NVHMH/Self_Balancing_Robot_PID/HW/mechanical/driver_board.jpg

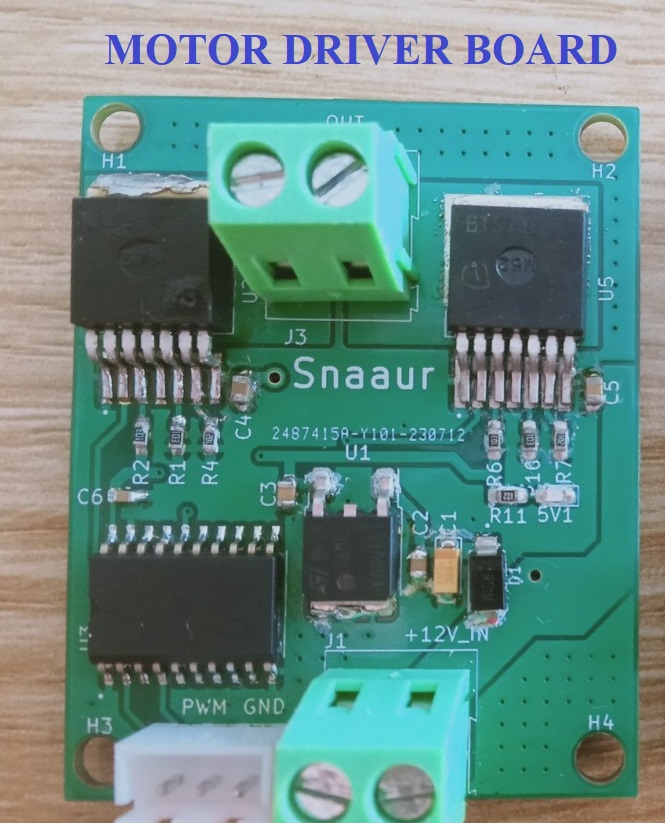
HW/mechanical/driver_board.jpg
