NVHMH/Self_Balancing_Robot_PID/HW/mechanical/main_board.jpg

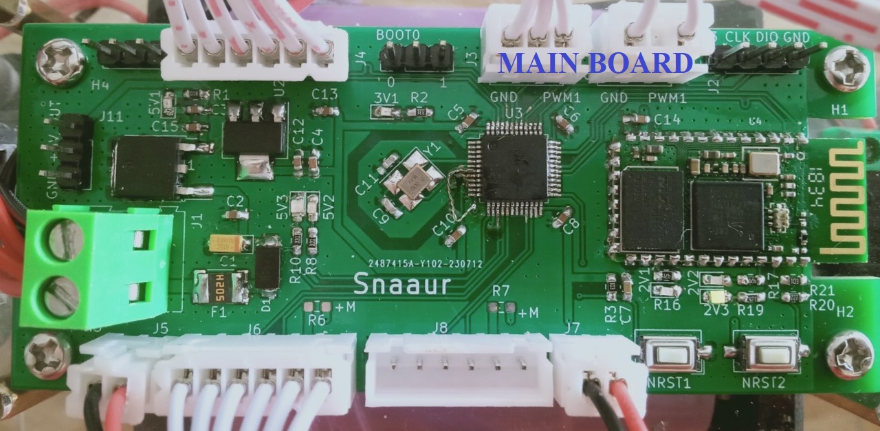
HW/mechanical/main_board.jpg
