NVHMH/Self_Balancing_Robot_PID/HW/mechanical/Front_robot.png

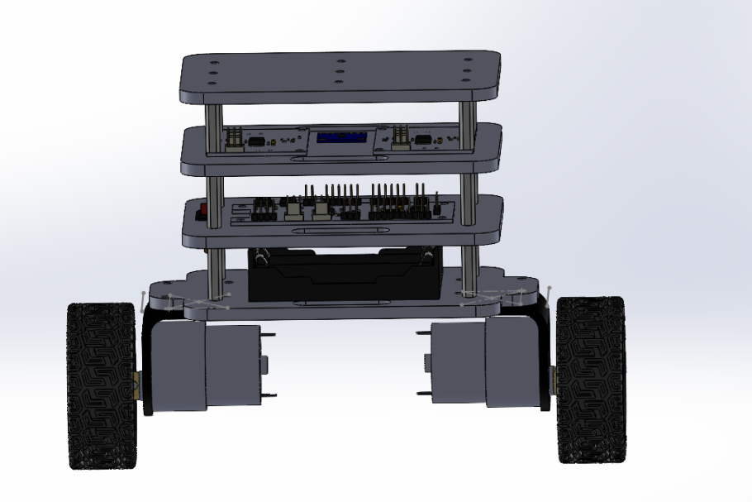
HW/mechanical/Front_robot.png
