NVHMH/Self_Balancing_Robot_PID/HW/mechanical/Right_robot.png

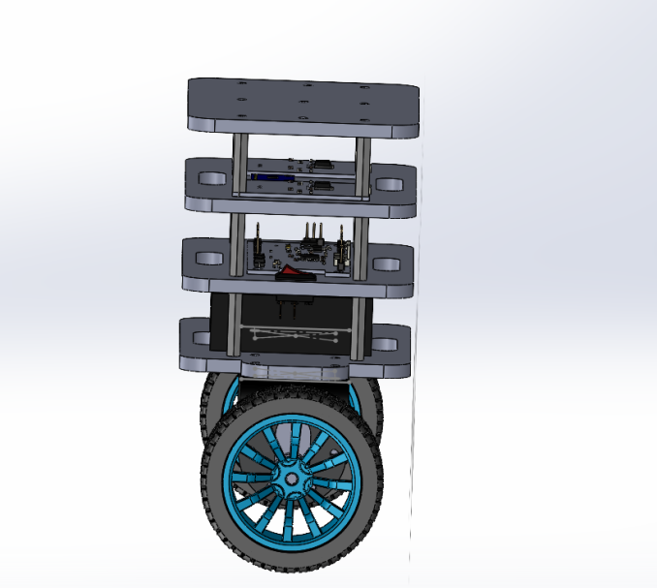
HW/mechanical/Right_robot.png
