NVHMH/Self_Balancing_Robot_PID/HW/mechanical/robot.jpg

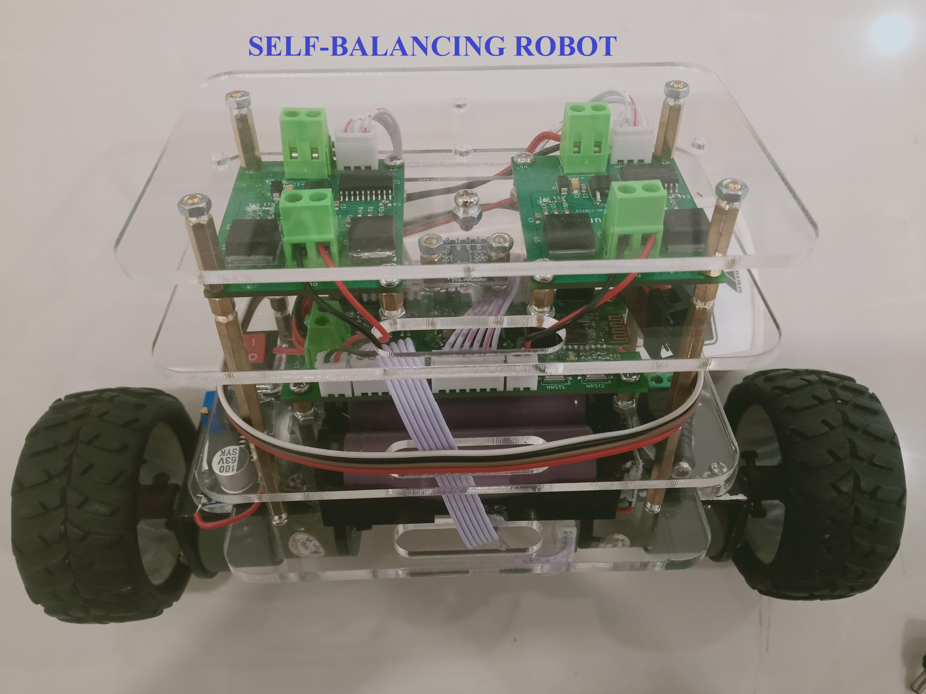
HW/mechanical/robot.jpg
