NVHMH/Self_Balancing_Robot_PID/HW/mechanical/Top_robot.png

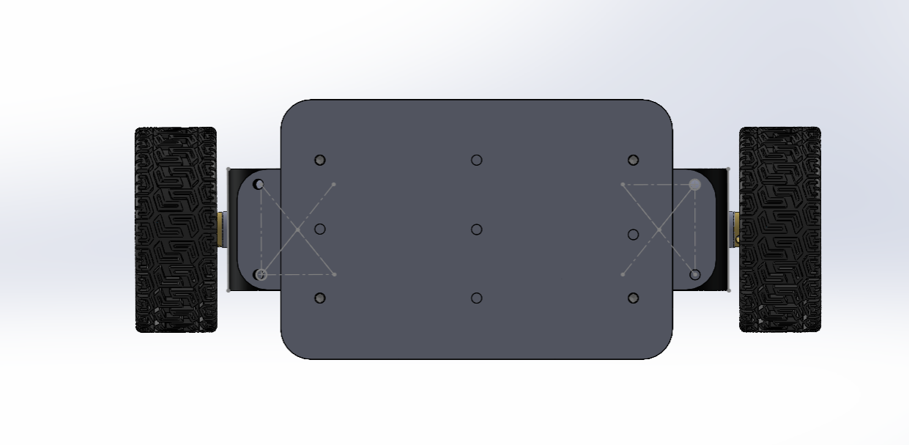
HW/mechanical/Top_robot.png
