NVHMH/Self_Balancing_Robot_PID/HW/main_board/snaaur_v1.xlsx

# | Reference | Qty | Value | Footprint | DNP
1 | 2V1 | 1 | RED | LED_SMD:LED_0603_1608Metric_Pad1.05x0.95mm_HandSolder | LED Xanh Lá 0603 Dán SMD Trong Suốt Size 1.6x0.8mm, điện áp 1.8-2.6VDC (thegioiic.com) (https://www.thegioiic.com/led-xanh-la-0603-dan-smd-trong-suot)
2 | 2V2 | 1 | YELLOW | LED_SMD:LED_0603_1608Metric_Pad1.05x0.95mm_HandSolder | LED Xanh Lá 0603 Dán SMD Trong Suốt Size 1.6x0.8mm, điện áp 1.8-2.6VDC (thegioiic.com) (https://www.thegioiic.com/led-xanh-la-0603-dan-smd-trong-suot)
3 | 2V3 | 1 | GREEN | LED_SMD:LED_0603_1608Metric_Pad1.05x0.95mm_HandSolder | LED Xanh Lá 0603 Dán SMD Trong Suốt Size 1.6x0.8mm, điện áp 1.8-2.6VDC (thegioiic.com) (https://www.thegioiic.com/led-xanh-la-0603-dan-smd-trong-suot)
4 | 3V1, 5V1, 5V2, 5V3 | 4 | LED | LED_SMD:LED_0603_1608Metric_Pad1.05x0.95mm_HandSolder | LED Đỏ 0603 Dán SMD Trong Suốt Size 1.6x0.8mm, điện áp 1.8-2.6VDC (thegioiic.com) (https://www.thegioiic.com/led-do-0603-dan-smd-trong-suot)
5 | C1 | 1 | 1u, 16V | Capacitor_Tantalum_SMD:CP_EIA-3216-18_Kemet-A_Pad1.58x1.35mm_HandSolder | Tụ Tantalum 1uF 16V 1206 TAJA105K016RNJ, Code 105 10%, 1206 (3216 Metric) (thegioiic.com) (https://www.thegioiic.com/tu-tantalum-1uf-16v-1206-taja105k016rnj)
6 | C2, C15 | 2 | 100nF,50V | Capacitor_SMD:C_0603_1608Metric_Pad1.05x0.95mm_HandSolder | Tụ Gốm 0603 100nF (0.1uF) 50V 10%, 0603 (1608 Metric) (thegioiic.com) (https://www.thegioiic.com/tu-gom-0603-100nf-0-1uf-50v)
7 | C3, C4, C5, C6, C7, C8, C10, C13, C14 | 9 | 100n | Capacitor_SMD:C_0603_1608Metric_Pad1.08x0.95mm_HandSolder | Tụ Gốm 0603 100nF (0.1uF) 50V 10%, 0603 (1608 Metric) (thegioiic.com) (https://www.thegioiic.com/tu-gom-0603-100nf-0-1uf-50v)
8 | C9, C11 | 2 | 22p | Capacitor_SMD:C_0603_1608Metric_Pad1.08x0.95mm_HandSolder | Tụ Gốm 0603 22pF 50V 10%, 0603 (1608 Metric) (thegioiic.com) (https://www.thegioiic.com/tu-gom-0603-22pf-50v)
9 | C12 | 1 | 4.7u thay bằng 1uF/16V | Capacitor_SMD:C_0603_1608Metric_Pad1.08x0.95mm_HandSolder | Tụ Gốm 0603 4.7uF 25V 10%, 0603 (1608 Metric) (thegioiic.com) (https://www.thegioiic.com/tu-gom-0603-4-7uf-25v)
10 | D1 | 1 | RS1M | RS1M:DIOM4330X250N | RS1M SMA Diode Chỉnh Lưu 1A 1KV, 1A, 1KV, SMA (thegioiic.com) (https://www.thegioiic.com/rs1m-sma-diode-chinh-luu-1a-1kv)
11 | F1 | 1 | Fuse | Fuse:Fuse_1812_4532Metric_Pad1.30x3.40mm_HandSolder | https://www.thegioiic.com/mf-msmf050-2-cau-chi-tu-phuc-hoi-1812-15v-0-5a
12 | H1, H2, H3, H4 | 4 | MountingHole | MountingHole:MountingHole_3.5mm | x
13 | J1 | 1 | POWER | TerminalBlock:TerminalBlock_Altech_AK300-2_P5.00mm | hàng rào đực
14 | J2 | 1 | Debug | Connector_PinHeader_2.54mm:PinHeader_1x04_P2.54mm_Vertical
15 | J3 | 1 | boot | Connector_PinHeader_2.54mm:PinHeader_1x03_P2.54mm_Vertical | x
16 | J4 | 1 | MPU6050 | Connector_PinHeader_2.54mm:PinHeader_1x10_P2.54mm_Vertical
17 | J5, J7 | 2 | Conn_01x02_Pin | Connector_PinHeader_2.54mm:PinHeader_1x02_P2.54mm_Vertical
18 | J6 | 1 | Motor1 | Connector_PinHeader_2.54mm:PinHeader_1x06_P2.54mm_Vertical | Dây Tín Hiệu Có Đầu Nối (thegioiic.com) (https://www.thegioiic.com/product/day-tin-hieu-co-dau-noi?prid=9485,9526)
19 | J8 | 1 | Motor2 | Connector_PinHeader_2.54mm:PinHeader_1x06_P2.54mm_Vertical | Đầu XH 2.54mm 6 Chân Thẳng Xuyên Lỗ, 250V 3A (thegioiic.com) (https://www.thegioiic.com/dau-xh-2-54mm-6-chan-thang-xuyen-lo)
20 | J9 | 1 | PWM1 | Connector_PinHeader_2.54mm:PinHeader_1x03_P2.54mm_Vertical | https://www.thegioiic.com/day-bus-cai-cai-3-tiep-diem-2-54mm-dai-20cm
21 | J10 | 1 | PWM2 | Connector_PinHeader_2.54mm:PinHeader_1x03_P2.54mm_Vertical | Đầu XH 2.54mm 3 Chân Thẳng Xuyên Lỗ, 250V 3A (thegioiic.com) (https://www.thegioiic.com/dau-xh-2-54mm-3-chan-thang-xuyen-lo)
22 | J11 | 1 | 5V_Output | Connector_PinHeader_2.54mm:PinHeader_1x02_P2.54mm_Vertical
23 | NRST1, NRST2 | 2 | SW_Push | Button_Switch_SMD:SW_DIP_SPSTx01_Slide_6.7x4.1mm_W6.73mm_P2.54mm_LowProfile_JPin | Nút Nhấn 3.5x6mm Cao 2.5mm 2 Chân SMD Đầu Trắng 12VDC 0.1A (thegioiic.com) (https://www.thegioiic.com/nut-nhan-3-5x6mm-cao-2-5mm-2-chan-smd-dau-trang)
24 | R1 | 1 | 1k | Resistor_SMD:R_0603_1608Metric_Pad0.98x0.95mm_HandSolder | Điện Trở 1 KOhm 0603 1%, Code 102, 1/10W (thegioiic.com) (https://www.thegioiic.com/dien-tro-1-kohm-0603-1)
25 | R2, R8, R10 | 3 | 330 | Resistor_SMD:R_0603_1608Metric_Pad0.98x0.95mm_HandSolder | Điện Trở 330 Ohm 0603 1%, Code 331, 1/10W (thegioiic.com) (https://www.thegioiic.com/dien-tro-330-ohm-0603-1-)
26 | R3, R21 | 2 | 10k | Resistor_SMD:R_0603_1608Metric_Pad0.98x0.95mm_HandSolder | Điện Trở 330 Ohm 0603 1%, Code 331, 1/10W (thegioiic.com) (https://www.thegioiic.com/dien-tro-330-ohm-0603-1-)
27 | R6, R7 | 2 | 0 | Resistor_SMD:R_0603_1608Metric_Pad0.98x0.95mm_HandSolder | Điện Trở 0 Ohm 0603 1%, Code 0R0, 1/10W (thegioiic.com) (https://www.thegioiic.com/dien-tro-0-ohm-0603-1)
28 | R16, R17, R19 | 3 | 470 | Resistor_SMD:R_0603_1608Metric_Pad0.98x0.95mm_HandSolder | Điện Trở 470 Ohm 0603 1%, Code 471, 1/10W (thegioiic.com) (https://www.thegioiic.com/dien-tro-470-ohm-0603-1-)
29 | R20 | 1 | 2.2k | Resistor_SMD:R_0603_1608Metric_Pad0.98x0.95mm_HandSolder | Điện Trở 2.2 KOhm 0603 1%, Code 222, 1/10W (thegioiic.com) (https://www.thegioiic.com/dien-tro-2-2-kohm-0603-1)
30 | U1 | 1 | L7805 | Package_TO_SOT_SMD:TO-252-2 | L78M05CDT IC Ổn Áp 5V 500mA Điện áp vào max: 35VDC, điện áp ra: 5VDC, TO-252 (thegioiic.com) (https://www.thegioiic.com/l78m05cdt-ic-on-ap-5v-500ma)
31 | U2 | 1 | AMS1117-3.3 | Package_TO_SOT_SMD:SOT-223-3_TabPin2 | AMS1117-3.3V IC Ổn Áp 3.3V 1A SOT-223 Điện áp vào max: 15VDC, điện áp ra: 3.3VDC (thegioiic.com) (https://www.thegioiic.com/ams1117-3-3v-ic-on-ap-3-3v-1a-sot-223)
32 | U3 | 1 | STM32F103C8Tx | Package_QFP:LQFP-48_7x7mm_P0.5mm | STM32F103C8T6 (icdayroi.com) (https://icdayroi.com/stm32f103c8t6)
33 | U4 | 1 | HC-05 | HC-05:XCVR_HC-05 | https://www.thegioiic.com/hc-05-thu-phat-bluetooth-chua-ra-chan-master-slave
34 | Y1 | 1 | Crystal | Crystal:Crystal_SMD_3225-4Pin_3.2x2.5mm_HandSoldering | Thạch Anh 8MHz 3225 4 Chân SMD Size: 3.2x2.5mm, ±15ppm 8pF (thegioiic.com) (https://www.thegioiic.com/thach-anh-8mhz-3225-4-chan-smd)
