NVHMH/Self_Balancing_Robot_PID/HW/driver_motor/driver_motor.step

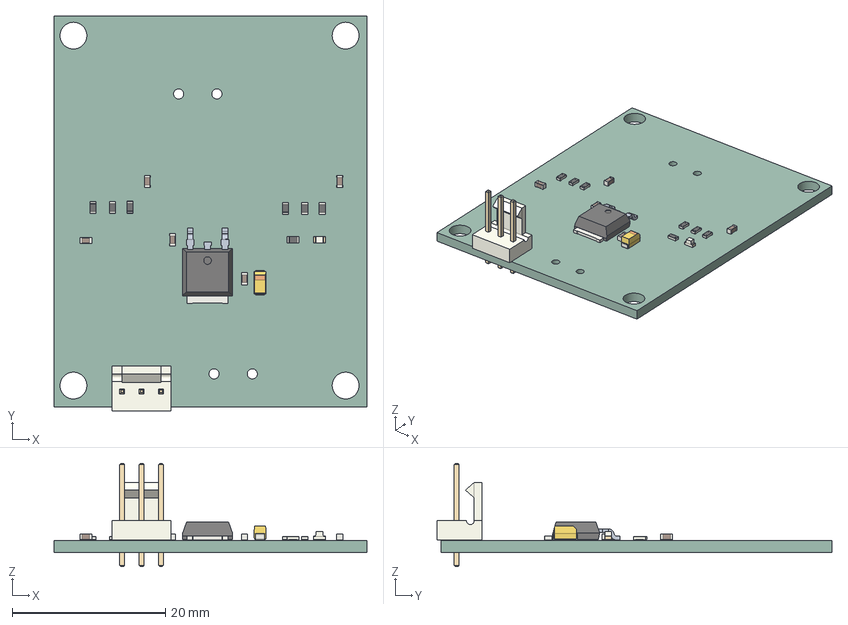
[picture p7: CAD file, 2023-07-31]
HW/driver_motor/driver_motor.step
40.9 x 51.6 x 13.5 mm
driver_motor PCB
