NVHMH/Self_Balancing_Robot_PID/(list of files, cad)

Other CAD files:
HW/mechanical/Simulation_solidworks/Self_balancing_robot_simulation.STEP[50].sldprt
HW/mechanical/Simulation_solidworks/Self_balancing_robot_simulation.STEP[133].sldprt
HW/mechanical/Simulation_solidworks/Self_balancing_robot_simulation.STEP[24].sldprt
HW/mechanical/Simulation_solidworks/Self_balancing_robot_simulation.STEP[82].sldprt
HW/mechanical/Simulation_solidworks/Self_balancing_robot_simulation.STEP[71].sldprt
HW/mechanical/Simulation_solidworks/Self_balancing_robot_simulation.STEP[119].sldprt
HW/mechanical/Simulation_solidworks/Self_balancing_robot_simulation.STEP[104].sldprt
HW/mechanical/Simulation_solidworks/Self_balancing_robot_simulation.STEP[99].sldprt
HW/mechanical/Simulation_solidworks/Self_balancing_robot_simulation.STEP[23].sldprt
HW/mechanical/Simulation_solidworks/Self_balancing_robot_simulation.STEP[98].sldprt
HW/mechanical/Simulation_solidworks/Self_balancing_robot_simulation.STEP[8].sldprt
HW/mechanical/Simulation_solidworks/Self_balancing_robot_simulation.STEP[130].sldprt
HW/mechanical/Simulation_solidworks/Self_balancing_robot_simulation.STEP[70].sldprt
HW/mechanical/Simulation_solidworks/Self_balancing_robot_simulation.STEP[37].sldprt
HW/mechanical/Simulation_solidworks/Self_balancing_robot_simulation.STEP[17].sldprt
HW/mechanical/Simulation_solidworks/Self_balancing_robot_simulation.STEP[55].sldprt
HW/mechanical/Simulation_solidworks/Self_balancing_robot_simulation.STEP[92].sldprt
HW/mechanical/Simulation_solidworks/Self_balancing_robot_simulation.STEP[75].sldprt
HW/mechanical/Simulation_solidworks/Self_balancing_robot_simulation.STEP[60].sldprt
HW/mechanical/Simulation_solidworks/Self_balancing_robot_simulation.STEP[41].sldprt
HW/mechanical/Simulation_solidworks/Self_balancing_robot_simulation.STEP[73].sldprt
HW/mechanical/Simulation_solidworks/Self_balancing_robot_simulation.STEP[90].sldprt
HW/mechanical/Simulation_solidworks/Self_balancing_robot_simulation.STEP[93].sldprt
HW/mechanical/Simulation_solidworks/Self_balancing_robot_simulation.STEP[116].sldprt
HW/mechanical/Simulation_solidworks/Self_balancing_robot_simulation.STEP[57].sldprt
HW/mechanical/Simulation_solidworks/Self_balancing_robot_simulation.STEP[122].sldprt
HW/mechanical/Simulation_solidworks/Self_balancing_robot_simulation.STEP[111].sldprt
HW/mechanical/Simulation_solidworks/Self_balancing_robot_simulation.STEP[32].sldprt
HW/mechanical/Simulation_solidworks/Self_balancing_robot_simulation.STEP[62].sldprt
HW/mechanical/Simulation_solidworks/Self_balancing_robot_simulation.STEP[20].sldprt
HW/mechanical/Simulation_solidworks/Self_balancing_robot_simulation.STEP[86].sldprt
HW/mechanical/Simulation_solidworks/Self_balancing_robot_simulation.STEP[5].sldprt
HW/mechanical/Simulation_solidworks/Self_balancing_robot_simulation.STEP[34].sldprt
HW/mechanical/Simulation_solidworks/Self_balancing_robot_simulation.STEP[88].sldprt
HW/mechanical/Simulation_solidworks/Self_balancing_robot_simulation.STEP[10].sldprt
HW/mechanical/Simulation_solidworks/Self_balancing_robot_simulation.STEP[21].sldprt
HW/mechanical/Simulation_solidworks/Self_balancing_robot_simulation.STEP[14].sldprt
HW/mechanical/Simulation_solidworks/Self_balancing_robot_simulation.STEP[101].sldprt
HW/mechanical/Simulation_solidworks/Self_balancing_robot_simulation.STEP[113].sldprt
HW/mechanical/Simulation_solidworks/Self_balancing_robot_simulation.STEP[33].sldprt
HW/mechanical/Simulation_solidworks/Self_balancing_robot_simulation.STEP[18].sldprt
HW/mechanical/Simulation_solidworks/Self_balancing_robot_simulation.STEP[117].sldprt
HW/mechanical/Simulation_solidworks/Self_balancing_robot_simulation.STEP[43].sldprt
HW/mechanical/Simulation_solidworks/Self_balancing_robot_simulation.STEP[31].sldprt
HW/mechanical/Simulation_solidworks/Self_balancing_robot_simulation.STEP[96].sldprt
HW/mechanical/Simulation_solidworks/Self_balancing_robot_simulation.STEP[49].sldprt
HW/mechanical/Simulation_solidworks/Self_balancing_robot_simulation.STEP[87].sldprt
HW/mechanical/Simulation_solidworks/Self_balancing_robot_simulation.STEP[85].sldprt
HW/mechanical/Simulation_solidworks/Self_balancing_robot_simulation.STEP[52].sldprt
HW/mechanical/Simulation_solidworks/Self_balancing_robot_simulation.STEP[106].sldprt
HW/mechanical/Simulation_solidworks/Self_balancing_robot_simulation.STEP[27].sldprt
HW/mechanical/Simulation_solidworks/Self_balancing_robot_simulation.STEP[77].sldprt
HW/mechanical/Simulation_solidworks/Self_balancing_robot_simulation.STEP[59].sldprt
HW/mechanical/Simulation_solidworks/Self_balancing_robot_simulation.STEP[16].sldprt
HW/mechanical/Simulation_solidworks/Self_balancing_robot_simulation.STEP[132].sldprt
HW/mechanical/Simulation_solidworks/Self_balancing_robot_simulation.STEP[39].sldprt
HW/mechanical/Simulation_solidworks/Self_balancing_robot_simulation.STEP[128].sldprt
HW/mechanical/Simulation_solidworks/Self_balancing_robot_simulation.STEP[2].sldprt
HW/mechanical/Simulation_solidworks/Self_balancing_robot_simulation.STEP[25].sldprt
HW/mechanical/Simulation_solidworks/Self_balancing_robot_simulation.STEP[127].sldprt
HW/mechanical/Simulation_solidworks/Self_balancing_robot_simulation.STEP[107].sldprt
HW/mechanical/Simulation_solidworks/Self_balancing_robot_simulation.STEP[67].sldprt
HW/mechanical/Simulation_solidworks/Self_balancing_robot_simulation.STEP[80].sldprt
HW/mechanical/Simulation_solidworks/Self_balancing_robot_simulation.STEP[29].sldprt
HW/mechanical/Simulation_solidworks/Self_balancing_robot_simulation.STEP[36].sldprt
HW/mechanical/Simulation_solidworks/Self_balancing_robot_simulation.STEP[131].sldprt
HW/mechanical/Simulation_solidworks/Self_balancing_robot_simulation.STEP[100].sldprt
HW/mechanical/Simulation_solidworks/Self_balancing_robot_simulation.STEP[19].sldprt
HW/mechanical/Simulation_solidworks/Self_balancing_robot_simulation.STEP[76].sldprt
HW/mechanical/Simulation_solidworks/Self_balancing_robot_simulation.STEP[44].sldprt
HW/mechanical/Simulation_solidworks/Self_balancing_robot_simulation.STEP[95].sldprt
HW/mechanical/Simulation_solidworks/Self_balancing_robot_simulation.STEP[78].sldprt
HW/mechanical/Simulation_solidworks/Self_balancing_robot_simulation.STEP[125].sldprt
HW/mechanical/Simulation_solidworks/Self_balancing_robot_simulation.STEP[7].sldprt
HW/mechanical/Simulation_solidworks/Self_balancing_robot_simulation.STEP[45].sldprt
HW/mechanical/Simulation_solidworks/Self_balancing_robot_simulation.STEP[42].sldprt
HW/mechanical/Simulation_solidworks/Self_balancing_robot_simulation.STEP[89].sldprt
HW/mechanical/Simulation_solidworks/Self_balancing_robot_simulation.STEP[129].sldprt
HW/mechanical/Simulation_solidworks/Self_balancing_robot_simulation.STEP[114].sldprt
HW/mechanical/Simulation_solidworks/Self_balancing_robot_simulation.STEP[48].sldprt
HW/mechanical/Simulation_solidworks/Self_balancing_robot_simulation.STEP[97].sldprt
HW/mechanical/Simulation_solidworks/Self_balancing_robot_simulation.STEP[110].sldprt
HW/mechanical/Simulation_solidworks/Self_balancing_robot_simulation.STEP[124].sldprt
HW/mechanical/Simulation_solidworks/Self_balancing_robot_simulation.STEP[65].sldprt
HW/mechanical/Simulation_solidworks/Self_balancing_robot_simulation.STEP[15].sldprt
HW/mechanical/Simulation_solidworks/Self_balancing_robot_simulation.STEP[51].sldprt
HW/mechanical/Simulation_solidworks/Self_balancing_robot_simulation.STEP[22].sldprt
HW/mechanical/Simulation_solidworks/Self_balancing_robot_simulation.STEP[126].sldprt
HW/mechanical/Simulation_solidworks/Self_balancing_robot_simulation.STEP[35].sldprt
HW/mechanical/Simulation_solidworks/Self_balancing_robot_simulation.STEP[109].sldprt
HW/mechanical/Simulation_solidworks/Self_balancing_robot_simulation.STEP[69].sldprt
HW/mechanical/Simulation_solidworks/Self_balancing_robot_simulation.STEP[123].sldprt
HW/mechanical/Simulation_solidworks/Self_balancing_robot_simulation.STEP[64].sldprt
HW/mechanical/Simulation_solidworks/Self_balancing_robot_simulation.STEP[112].sldprt
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
