NVHMH/Self_Balancing_Robot_PID/Document_Report/tune_pid.xlsx

kp | ki | kd | setpoint | MAX_CNT | MIN_CNT | t_angle (ms) | t_example(ms)
0.095 | 1e-05 | 0.001 | 0 | 1899 | 100 | 10 | 10
0.08 | 1e-07 | 1e-06 | -3 | 1899 | 300 | 10 | 10
0.08 | 1e-07 | 0.0001 | -3 | 1899 | 300 | 10 | 10
0.05 | 0.0009 | 0.0001 | -2 | 1899 | 100 | 5 | 5
0.05 | 0.001 | 0.0002 | -2 | 1899 | 100 | 5 | 5
0.04 | 0.005 | 2e-05 | -2 | 1899 | 100 | 5 | 5
0.05 | 0.005 | 2e-05 | -2 | 1899 | 100 | 5 | 5
0.05 | 0.00029 | 0.00000x | -2 | 1899 | 100 | 10 | 10
0.05 | 0.00029 | 9e-05 | -2 | 1899 | 100 | 10 | 10
