NVHMH/Self_Balancing_Robot_PID/HW/main_board/snaaur_v1.kicad_pcb

## KiCad design HW/main_board/snaaur_v1.kicad_pcb (2023-10-02)

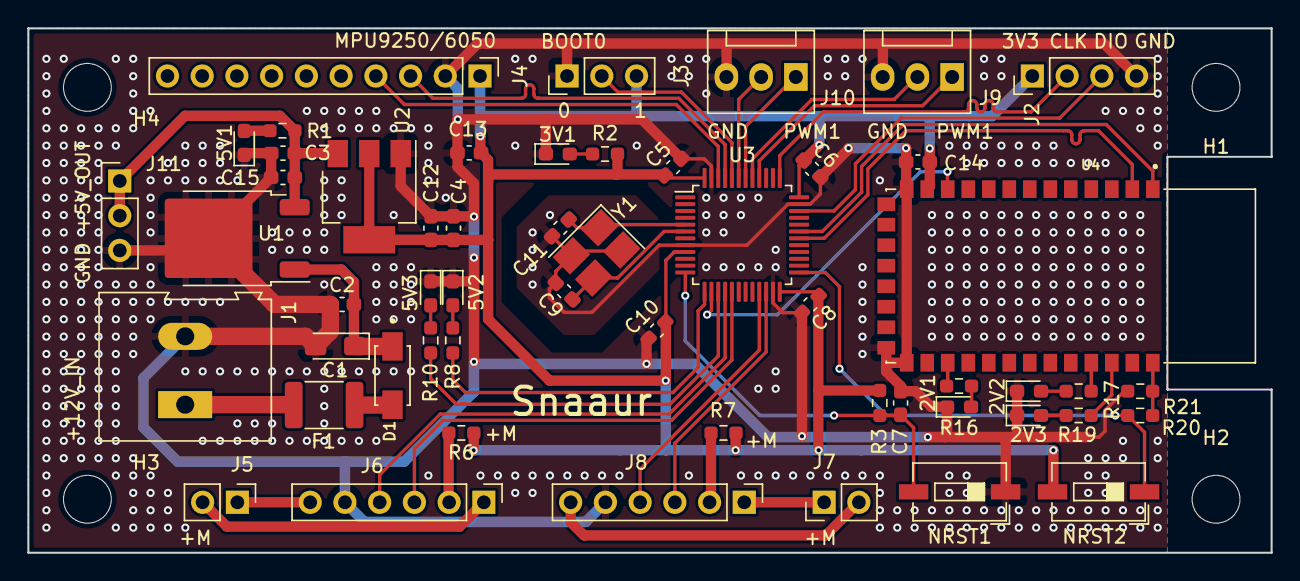
[picture p13: board snaaur_v1.kicad_pcb from above]

Board: 2 copper layers, 90.9 x 38.4 mm, 58 parts (0 on the bottom side), 45 nets.

Parts:
2V1: RED; LED_0603_1608Metric_Pad1.05x0.95mm_HandSolder
2V2: YELLOW; LED_0603_1608Metric_Pad1.05x0.95mm_HandSolder
2V3: GREEN; LED_0603_1608Metric_Pad1.05x0.95mm_HandSolder
3V1, 5V1, 5V2, 5V3: LED; LED_0603_1608Metric_Pad1.05x0.95mm_HandSolder
C1: 1u, 16V; CP_EIA-3216-18_Kemet-A_Pad1.58x1.35mm_HandSolder
C2, C15: 100nF,50V; C_0603_1608Metric_Pad1.08x0.95mm_HandSolder
C3, C4, C5, C6, C7, C8, C10, C13, C14: 100n; C_0603_1608Metric_Pad1.08x0.95mm_HandSolder
C9, C11: 22p; C_0603_1608Metric_Pad1.08x0.95mm_HandSolder
C12: 4.7u; C_0603_1608Metric_Pad1.08x0.95mm_HandSolder
D1: RS1M; DIOM4330X250N
F1: Fuse; Fuse_1812_4532Metric_Pad1.30x3.40mm_HandSolder
H1, H2, H3, H4: MountingHole; MountingHole_3.5mm
J1: POWER; TerminalBlock_Altech_AK300-2_P5.00mm
J2: Debug; PinHeader_1x04_P2.54mm_Vertical
J3: boot; PinHeader_1x03_P2.54mm_Vertical
J4: MPU6050; PinHeader_1x10_P2.54mm_Vertical
J5, J7: Conn_01x02_Pin; PinHeader_1x02_P2.54mm_Vertical
J6: Motor1; PinHeader_1x06_P2.54mm_Vertical
J8: Motor2; PinHeader_1x06_P2.54mm_Vertical
J9: PWM1; FanPinHeader_1x03_P2.54mm_Vertical
J10: PWM2; FanPinHeader_1x03_P2.54mm_Vertical
J11: 5V_OUT; PinHeader_1x03_P2.54mm_Vertical
NRST1, NRST2: SW_Push; SW_DIP_SPSTx01_Slide_6.7x4.1mm_W6.73mm_P2.54mm_LowProfile_J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
R1: 1k; R_0603_1608Metric_Pad0.98x0.95mm_HandSolder
R2, R8, R10: 330; R_0603_1608Metric_Pad0.98x0.95mm_HandSolder
R3, R21: 10k; R_0603_1608Metric_Pad0.98x0.95mm_HandSolder
R6, R7: 0; R_0603_1608Metric_Pad0.98x0.95mm_HandSolder
R16, R17, R19: 470; R_0603_1608Metric_Pad0.98x0.95mm_HandSolder
R20: 2.2k; R_0603_1608Metric_Pad0.98x0.95mm_HandSolder
U1: L7805; TO-252-2
U2: AMS1117-3.3; SOT-223-3_TabPin2
U3: STM32F103C8Tx; LQFP-48_7x7mm_P0.5mm
U4: HC-05; XCVR_HC-05
Y1: Crystal; Crystal_SMD_3225-4Pin_3.2x2.5mm_HandSoldering

Connections:
+3.3V: C4.2, C5.1, C6.1, C8.1, C10.1, C12.1, C13.1, C14.2, J2.1, J3.3, J4.1, NRST2.2, R2.1, R3.1, R6.1, R7.1, U2.2 (VO), U3.9 (VDDA), U3.24 (VDD), U3.36 (VDD), U3.48 (VDD), U4.12 (3.3_VCC)
+5V: C3.2, C15.2, J11.1, J11.2, R1.1, U1.3 (OUT), U2.3 (VI)
+12V: F1.1, J1.1
+M1: J5.2, J6.1
+M2: J7.1, J8.1
-M1: J5.1, J6.6
-M2: J7.2, J8.6
/PWM1_CH1: J9.1, U3.40 (PB4)
/PWM2_CH1: J10.1, U3.42 (PB6)
BLE_ENB: NRST2.1, R20.1, U3.25 (PB12)
BLUE_RESET: U3.14 (PA4), U4.11 (~RESETB)
BLUE_RX: U3.30 (PA9), U4.2 (UART-RX)
BLUE_TX: U3.31 (PA10), U4.1 (UART-TX)
BOOT0: J3.2, U3.44 (BOOT0)
GND: 2V1.1 (K), 2V2.1 (K), 2V3.1 (K), 3V1.1 (K), 5V1.1 (K), 5V2.1 (K), 5V3.1 (K), C1.2, C2.1, C3.1, C4.1, C5.2, C6.2, C7.1, C8.2, C9.2, C10.2, C11.1, C12.2, C13.2, C14.1, C15.1, J1.2, J2.4, J3.1, J4.2, J6.5, J8.5, J9.3, J10.3, J11.3, NRST1.1, R21.2, U1.2 (GND), U2.1 (GND), U3.8 (VSSA), U3.23 (VSS), U3.35 (VSS), U3.47 (VSS), U4.13 (GND), U4.21 (GND), U4.22 (GND), Y1.2, Y1.4
IMU_SCL: J4.3, U3.45 (PB8)
IMU_SDA: J4.4, U3.46 (PB9)
LED1: R8.1, U3.13 (PA3)
LED2: R10.1, U3.15 (PA5)
NRST: C7.2, NRST1.2, R3.2, U3.12 (PA2)
unnamed: 2V1.2 (A), R16.2
unnamed: 2V2.2 (A), R17.2
unnamed: 2V3.2 (A), R19.2
unnamed: 3V1.2 (A), R2.2
unnamed: 5V1.2 (A), R1.2
unnamed: 5V2.2 (A), R8.2
unnamed: 5V3.2 (A), R10.2
unnamed: D1.A, F1.2
unnamed: J6.2, R6.2
unnamed: J8.2, R7.2
unnamed: J9.2, U3.41 (PB5)
unnamed: J10.2, U3.43 (PB7)
unnamed: C1.1, C2.2, D1.C, U1.1 (IN)
unnamed: R16.1, U4.24 (PIO[1])
unnamed: R17.1, U4.31 (PIO[8])
unnamed: R19.1, U4.32 (PIO[9])
unnamed: R20.2, R21.1, U4.34 (PIO[11])
OSC1: C11.2, U3.5 (PD0), Y1.1
OSC2: C9.1, U3.6 (PD1), Y1.3
SWCLK: J2.2, U3.37 (PA14)
SWDIO: J2.3, U3.34 (PA13)
enc_in_1a: J6.4, U3.16 (PA6)
enc_in_1b: J6.3, U3.17 (PA7)
enc_in_2a: J8.4, U3.21 (PB10)
enc_in_2b: J8.3, U3.22 (PB11)
