NVHMH/Self_Balancing_Robot_PID/HW/driver_motor/driver_motor.kicad_pcb

## KiCad design HW/driver_motor/driver_motor.kicad_pcb (2023-07-31)

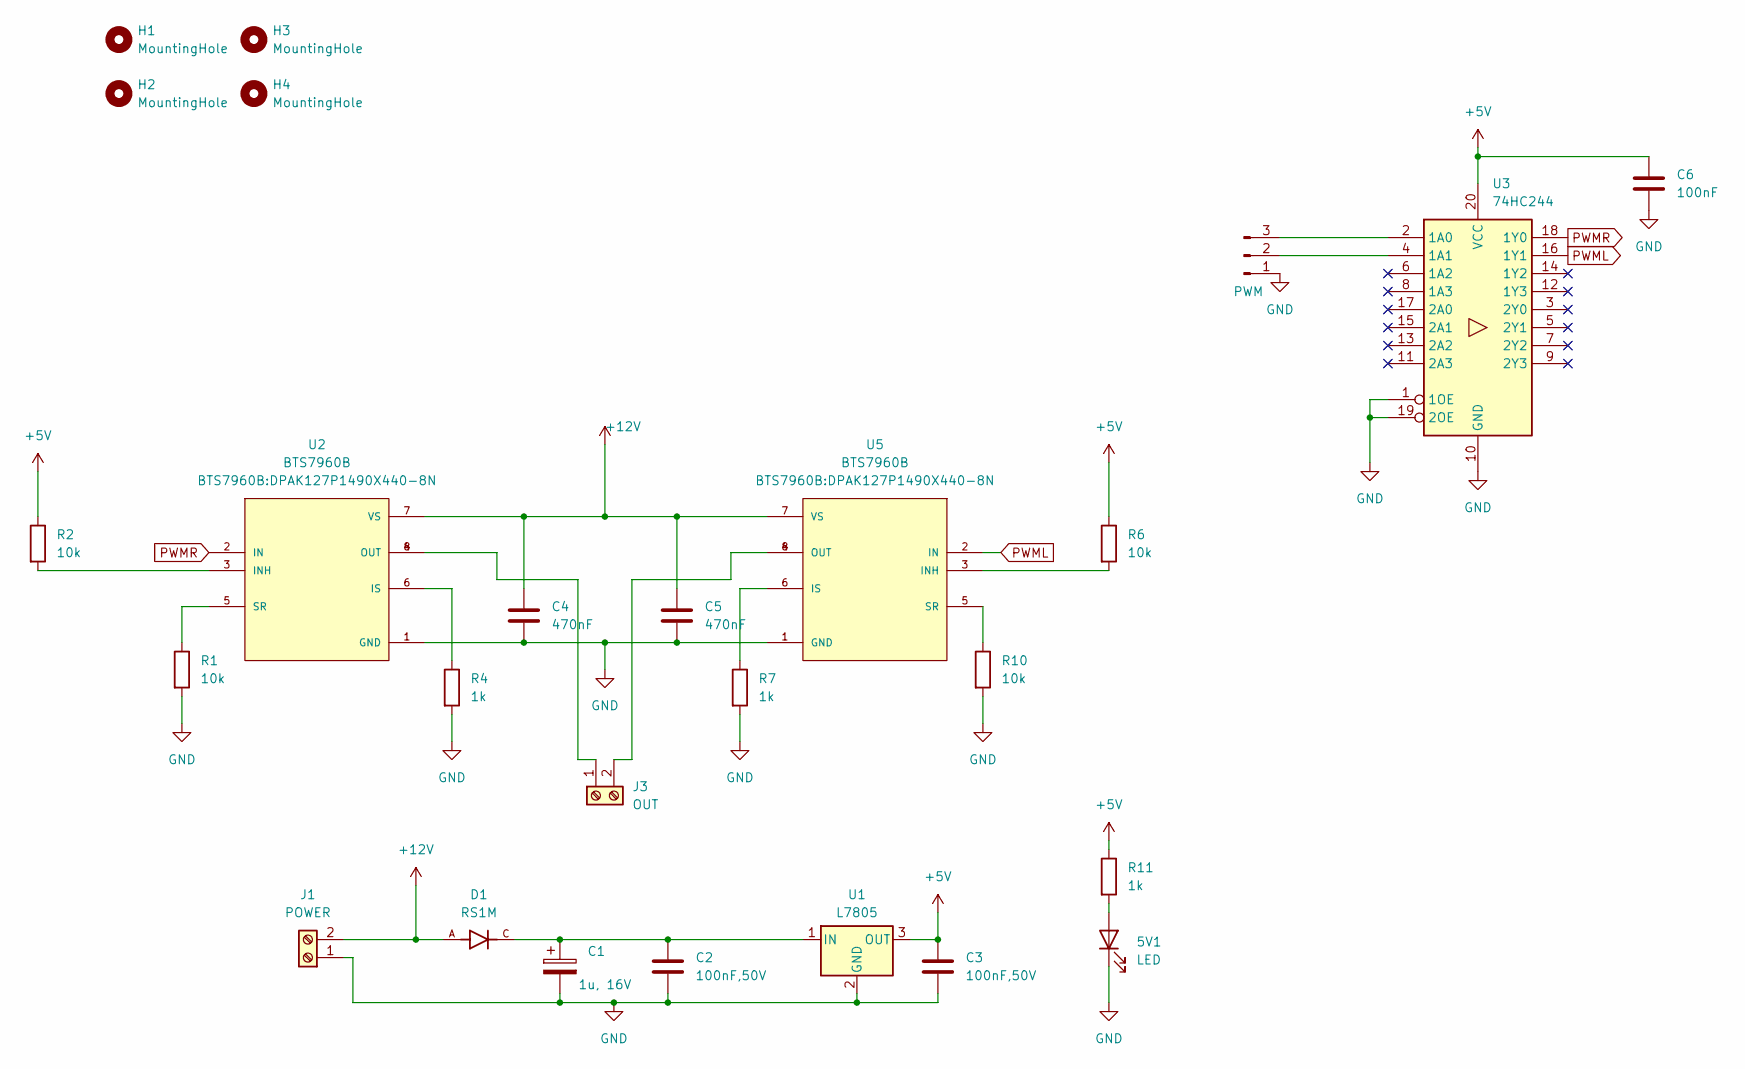
[picture p14: schematic driver_motor.kicad_sch, Motor Driver]

Parts:
5V1: LED; LED_0603_1608Metric_Pad1.05x0.95mm_HandSolder
C1: 1u, 16V; CP_EIA-3216-18_Kemet-A_Pad1.58x1.35mm_HandSolder
C2, C3: 100nF,50V; C_0603_1608Metric_Pad1.08x0.95mm_HandSolder
C4, C5: 470nF; C_0603_1608Metric_Pad1.08x0.95mm_HandSolder
C6: 100nF; C_0603_1608Metric_Pad1.08x0.95mm_HandSolder
D1: RS1M; DIOM4330X250N; PARTREV 1.0
H1, H2, H3, H4: MountingHole; MountingHole_3.5mm
J1: POWER; TerminalBlock_Altech_AK300-2_P5.00mm
J2: PWM; FanPinHeader_1x03_P2.54mm_Vertical
J3: OUT; TerminalBlock_Altech_AK300-2_P5.00mm
R1, R2, R6, R10: 10k; R_0603_1608Metric_Pad0.98x0.95mm_HandSolder
R4, R7, R11: 1k; R_0603_1608Metric_Pad0.98x0.95mm_HandSolder
U1: L7805; TO-252-2
U2, U5: BTS7960B; DPAK127P1490X440-8N; PARTREV 1.1
U3: 74HC244; SOIC127P1030X265-20N

Connections:
+5V: C3.2, C6.1, R2.1, R6.1, R11.1, U1.3 (OUT), U3.20 (VCC)
+12V: C4.2, C5.1, D1.A, J1.2, U2.7 (VS), U5.7 (VS)
GND: 5V1.1 (K), C1.2, C2.1, C3.1, C4.1, C5.2, C6.2, J1.1, J2.1, R1.2, R4.2, R7.2, R10.2, U1.2 (GND), U2.1 (GND), U3.1 (1OE), U3.10 (GND), U3.19 (2OE), U5.1 (GND)
unnamed: 5V1.2 (A), R11.2
unnamed: J2.2, U3.4 (1A1)
unnamed: J2.3, U3.2 (1A0)
unnamed: J3.1, U2.4 (OUT), U2.8 (OUT)
unnamed: J3.2, U5.4 (OUT), U5.8 (OUT)
unnamed: C1.1, C2.2, D1.C, U1.1 (IN)
unnamed: R2.2, U2.3 (INH)
unnamed: R4.1, U2.6 (IS)
unnamed: R1.1, U2.5 (SR)
unnamed: R6.2, U5.3 (INH)
unnamed: R7.1, U5.6 (IS)
unnamed: R10.1, U5.5 (SR)
PWML: U3.16 (1Y1), U5.2 (IN)
PWMR: U2.2 (IN), U3.18 (1Y0)

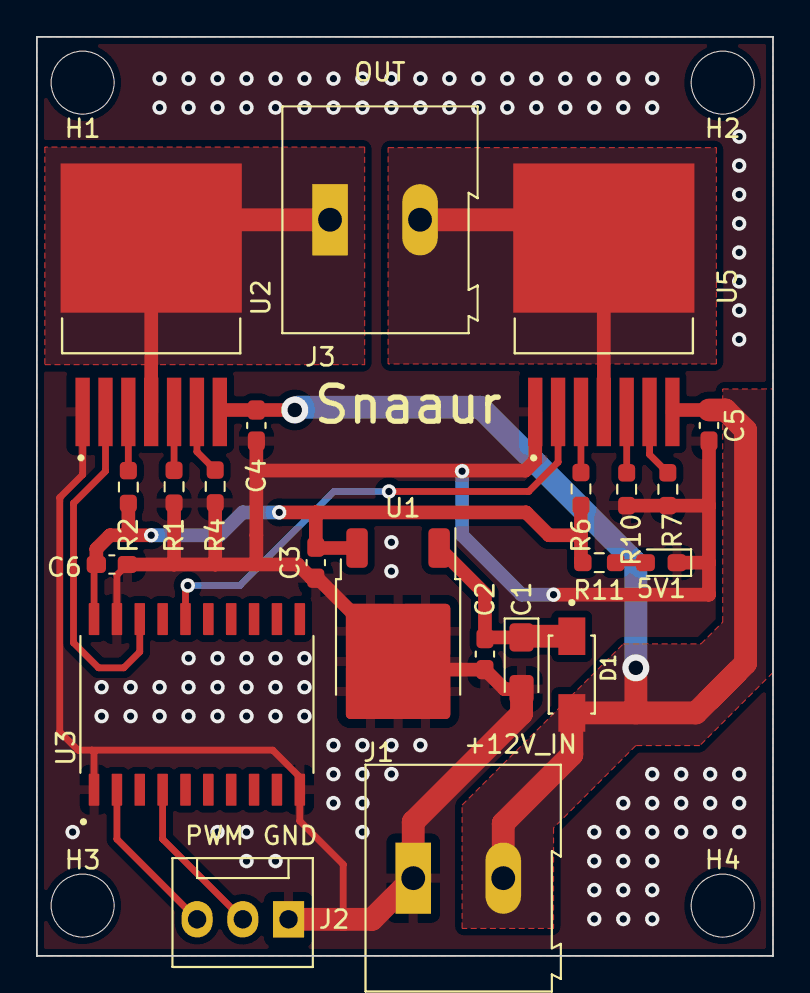
[picture p15: board driver_motor.kicad_pcb from above]

Board: 2 copper layers, 40.9 x 51.1 mm, 26 parts (0 on the bottom side), 17 nets.
