NVHMH/Self_Balancing_Robot_PID/FW/Self_Balancing_Robot/Core/Src/main.c

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
/* Includes ------------------------------------------------------------------*/
#include "main.h"

/* USER CODE BEGIN Includes */
#include <mpu6050.h>
#include <motor.h>
/* USER CODE END Includes */

I2C_HandleTypeDef hi2c1;

TIM_HandleTypeDef htim1;
TIM_HandleTypeDef htim3;
TIM_HandleTypeDef htim4;

UART_HandleTypeDef huart1;

/* USER CODE BEGIN PV */
	MPU6050_t	t_MPU6050;

	PID_t		t_pid = {
				.f_Kp 		= 0.05,
				.f_Ki		= 0.00029,
				.f_Kd		= 0.00001,
				.f_setpoint = -2.0,
	};

	uint8_t		u8_flag_10ms = 0;
	double		d_angle;
	uint8_t 	u8_rx_data;

/* USER CODE END PV */

void SystemClock_Config(void);
static void MX_GPIO_Init(void);
static void MX_I2C1_Init(void);
static void MX_TIM1_Init(void);
static void MX_TIM3_Init(void);
static void MX_TIM4_Init(void);
static void MX_USART1_UART_Init(void);
/* USER CODE BEGIN 0 */
void HAL_TIM_PeriodElapsedCallback(TIM_HandleTypeDef *htim)
{
	if(htim->Instance==TIM1)
	{
		u8_flag_10ms = 1;
	}
}

void HAL_UART_RxCpltCallback(UART_HandleTypeDef *huart)
{
	if(huart->Instance == USART1){
		if(u8_rx_data == 'P'){
			t_pid.f_Kp += 0.001;
		}
		if(u8_rx_data == 'p'){
			t_pid.f_Kp -= 0.001;
		}
		if(u8_rx_data == 'I'){
			t_pid.f_Ki += 0.000001;
		}
		if(u8_rx_data == 'i'){
			t_pid.f_Ki -= 0.000001;
		}
		if(u8_rx_data == 'D'){
			t_pid.f_Kd += 0.0001;
		}
		if(u8_rx_data == 'd'){
			t_pid.f_Kd -= 0.0001;
		}
		if(u8_rx_data == 'O'){
			t_pid.f_setpoint += 0.5;
		}
		if(u8_rx_data == 'o'){
			t_pid.f_setpoint -= 0.5;
		}
		if(u8_rx_data == '0'){
			HAL_GPIO_WritePin(GPIOA, GPIO_PIN_3, 0);
		}
		if(u8_rx_data == '1'){
			HAL_GPIO_WritePin(GPIOA, GPIO_PIN_3, 1);

		}
		HAL_UART_Receive_IT(&huart1,&u8_rx_data,1);
	}

}
/* USER CODE END 0 */

/**
  * @brief  The application entry point.
  * @retval int
  */
int main(void)
{
  /* MCU Configuration--------------------------------------------------------*/

  /* Reset of all peripherals, Initializes the Flash interface and the Systick. */
  HAL_Init();

  /* Configure the system clock */
  SystemClock_Config();

  /* Initialize all configured peripherals */
  MX_GPIO_Init();
  MX_I2C1_Init();
  MX_TIM1_Init();
  MX_TIM3_Init();
  MX_TIM4_Init();
  MX_USART1_UART_Init();
  /* USER CODE BEGIN 2 */
  HAL_UART_Receive_IT(&huart1,&u8_rx_data,1);
  HAL_TIM_Base_Start_IT(&htim1);
  Init_tim_pwm();

  while (MPU6050_Init(&hi2c1) == 1);

  Reset_PID(&t_pid);

//  HAL_GPIO_WritePin(GPIOA, GPIO_PIN_3, 1);
//  HAL_GPIO_WritePin(GPIOA, GPIO_PIN_5, 1);
//  HAL_Delay(5000);
//  HAL_GPIO_WritePin(GPIOA, GPIO_PIN_3, 0 );
  /* USER CODE END 2 */

  /* Infinite loop */
  /* USER CODE BEGIN WHILE */
  while (1)
  {
    /* USER CODE END WHILE */

    /* USER CODE BEGIN 3 */


	  if (u8_flag_10ms)
	  {
		  u8_flag_10ms = 0;
		  MPU6050_Read_All(&hi2c1,&t_MPU6050);
		  d_angle = t_MPU6050.KalmanAngleY;
		  PID_controller(d_angle,&t_pid);
		  Control_motor(d_angle,&t_pid);
	  }
  }
  /* USER CODE END 3 */
}

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
