NVHMH/Self_Balancing_Robot_PID/(commit log)

2023-07-31 create folder structure and add hw
    [block_diagram.kicad_sch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]
2023-08-08 add FW
    [Self_Balancing_Robot Debug.cfg, size.kicad_pcb, size.kicad_sch]
2023-10-02 update demo
    [Self_balancing_robot_simulation.STEP[100].sldprt, Self_balancing_robot_simulation.STEP[101].sldprt, Self_balancing_robot_simulation.STEP[102].sldprt, Self_balancing_robot_simulation.STEP[104].sldprt, Self_balancing_robot_simulation.STEP[105].sldprt, Self_balancing_robot_simulation.STEP[106].sldprt, Self_balancing_robot_simulation.STEP[107].sldprt, Self_balancing_robot_simulation.STEP[108].sldprt]
